dogukanburda/Multichannel_Analyzer/Design Project 1.pdf

# ISTANBUL TECHNICAL UNIVERSITY

## FACULTY OF SCIENCE AND LETTERS

## Physics Engeering Design I Report

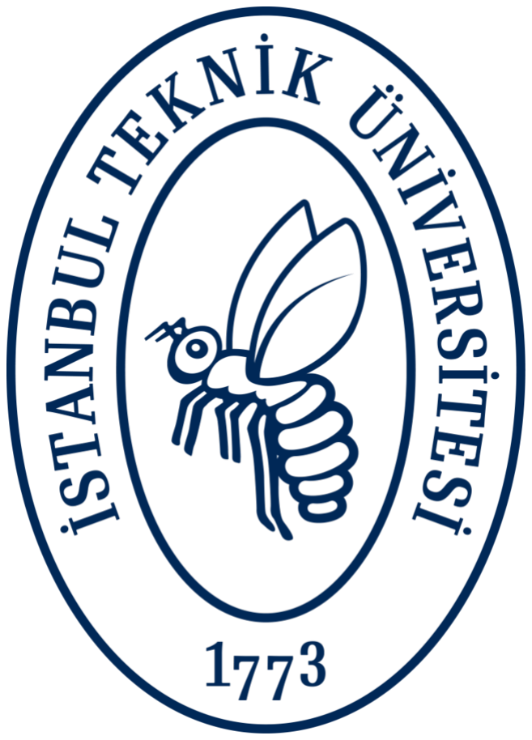
[picture p1: figure]

## Design of a microprocessor based multichannel analyzer for radon detection

### Osman Do˘gukan Kefeli

Department : Physics Engineering

ID | : 090170119
Advisor | : Prof. Dr. Cenap S¸. Ozben ¨
| Spring 2020/2021

## ABSTRACT

This report describes the design of a microprocessor based multichannel analyzer going to be used for radon detection. A silicon PIN photodiode was used for detecting alpha particles. The main advantages of this design are being low cost and low power consumption. Detector in question is planned to be used in the project related to the prediction of eqrtquakes by measuring radon levels in soil. Radon is a naturally occuring noble gas originated from radioactive decay series of 238U,²³⁵U. Since it lacks

any odor, taste it is impossible for humans to sense. However, it is possible to measure the activity of radon in desired location with modern nuclear instrumentation. Radon gas emissions must concern every household medically because respiration of high concentrations of radon poses great danger to lung health. In order to measure radon activity levels, designing and building a compact, self-sufficient device would be extremely beneficial. Therefore the aim of this study is to utilize modern equipments to detect radioactivity and gather relevant data. Data acquisiton from the silicon PIN photodiode is achieved with a pulse amplifying circuitry and a microcontroller unit. This data then displayed simultaneously for nuclear spectroscopy for radon gas.

i

## ACKNOWLEDGEMENTS

I would like to express my deepest appreciation to my advisor Prof. Dr. Cenap S¸. OZBEN for guiding me in the steps of this work. ¨

Osman Do˘gukan Kefeli

ii

### CONTENTS

ABSTRACT | i
ACKNOWLEDGEMENTS | ii
CONTENTS | iii
ABBREVIATION | iv
1 INTRODUCTION | 1
2 MICROPROCESSOR AND COMPONENTS | 7
3 Results and Discussion | 11
4 Conclusion | 13
5 Appendix | 14
REFERENCES | 20

iii

### ABBREVIATIONS

α | Greek letter minuscule alpha
β | Greek letter minuscule beta
γ | Greek letter minuscule gamma
µs | Micro Second
MCA | Multi Channel Analyzer
MeV | Mega Electron Volt
Ra | Radium
Rn | Radon
ROI | Region Of Interest
T h | Thorium
U | Uranium

iv

### INTRODUCTION

Radiation is the release of energy in the form of moving waves or streams of particles. In nuclear physics there are four main types of radiation and therefore different radiation detection methods. These four main radiation types are heavy charged particles, β (beta) particles, X and γ (gamma) rays and neutrons. Since

the radiation is a form of energy, in nuclear physics this energy is presented in MeV scale. An electron-volt eV is defined as the energy to accelerate one electron in 1V potential. Which the energy corresponds to a few picojoules.

## 1.1 Detection of Radiation

There are various methods for radiation detection. Each technique is used for analyzing different parameters. Detection of radiation can be seperated into four main subclasses with respect to their purposes. First, instinct is to directly detect the existence of radiation process in the environment. This method classifies the existence of the radiation by a threshold parameter and gives a definitive result. Another neccesity is to monitor the radiation with respect to time to get information about source strength. Third method is analyzing the radiation in order to determine the source’s type. This can be done by energy spectroscopy methods. Another commonly used procedure is dosimetry. Dosimetry is a technique of measuring and calculating how much radiation a material or living tissue is exposed to, directly or indirectly, to radioactive radiation. In the field of medicine, the amount of radiation given to patients for treatment is measured by dosimetry methods and kept under control.
Radiation characteristics consist of three main classifications. X and Gamma rays interact with the spins of electrons in the target material and cause ionization. On the other hand, heavy ions interact with both target electrons and nuclei and uncharged particles such as neutrons interact with the target nucleus. They are either absorbed or scattered from the target nucleus. Uncharged particles do not scatter from electrons.
The operation of any radiation detector is largely determined by how the radiation to be detected interacts with the detector’s material [1]. In order to construct a

radiation detection system first of all targeted radiation type must taken into account. Then operating range must be optimized to the target intensity for efficiency. Radon detection system can be constructed with instrumentation of solid-state silicon detectors. This electronic components are able to detect alpha particles emitted by radon.

## 1.2 Nuclear Spectroscopy

Nuclear spectroscopy used as a quick analytical method for applications like isotope identification [2], nuclear forensics [3], astrophysics [4], medical diagnosis [5]

etc. Nuclear spectroscopy includes measurements of gamma rays, charged particles and neutrons emitted from the nuclear reactions or decay of radioactive nuclei. It is mainly utilized with the properties of individual levels such as energy, angular momentum, spin, magnetic and electric moments and transition rates. In nuclear spectroscopy, energy is emitted as beta radiation, alpha radiation or in the form of photons in the gamma-ray range. With the help of mesasurement techniques radiation spectrum of the nucleus is detected in order to identify certain properties to discover the unknown. Instrumentation of electronics to detect the energies emitted by the nuclei have enabled advanced nuclear spectroscopy methods, resulting a more precise enviroment for nuclear data analysis. Further developments have made nuclear physics revolutionary for fields such as nuclear forensics, homeland security, imaging and diagnostics, radiation treatment, material science, art and archaeology. In digital nuclear spectroscopy, the digitizer plays the most important role in the performance of the spectrum analyzer system.

## 1.3 Single Channel Analyzer

Single channel analyzers have been used for measuring pulse amplitude. Single channel analyzer has two adjustable voltage tresholds and produces an output logic pulse depending on the conditions that its input signal falls within the two pre-set treshold levels [6].

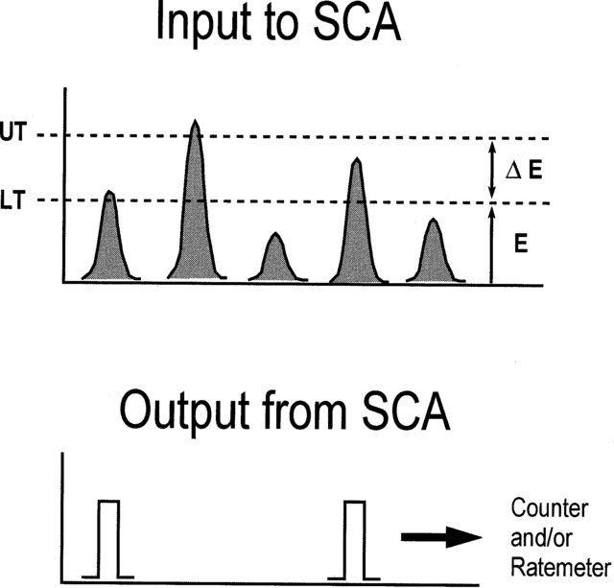
[picture p2: figure]

Figure 1.1: Pulse height analysis in a single-channel analyzer [7].

Figure above shows that pulses that yields between lower threshold (LT) and upper treshold (UT) digitized as a TTL pulse by the single channel analyzer. This is a good

practice for counting the rate of a certain radiation that has known characteristic energy.
However, when it is important to measure the corresponding energy of each pulse, this process must be done for every small ∆E energy range covering from the ground up. For this purpose multi channel analyzers evolved and utilized from the single channel analyzers. In principle a MCA, equivalent to many independent single channel analyzers consists of conitinous arranged windows [8]. Due to rapid

advancements in semiconductor and integrated circuit technology, today’s spectrometry system generally includes an analog-to-digital converter (ADC) for digitizing

the input pulse.

## 1.4 Multi Channel Analyzer

The multi channel analyzer (MCA) system consists of several key principle com-

ponents. These are simply data acquisition module, processing and storage unit, an analog-to-digital converter and a visual display module. MCA scans each energy channel that the system is capable of measuring. Records the number of pulse counts for each energy and logs the data in attainable format for determining the nuclide in nuclear spectroscopy system.
The ADC conversion unit utilizes the electrical analog signals to equivalent bytes to make sense in digital interface for further computational analysis.
Multi channel analyzer operates in two different modes. First one is pulse height analyzer mode, input pulses are mapped to bins by their amplitudes. Each bin represents an energy range and this its precision depends on the analyzer’s resolution. Second mode is the multi channel scaler mode, where pulses are sorted according to the time of arrival. MCA in design provides a visual display for realtime monitoring of the pulse height spectrum. Graph displayed on the screen provides the number of counts vs. channel number, basically a histogram of the number of counts vs pulse height. Number of pulse heights are analyzed with upper and lower level discriminators that can be adjusted manually.

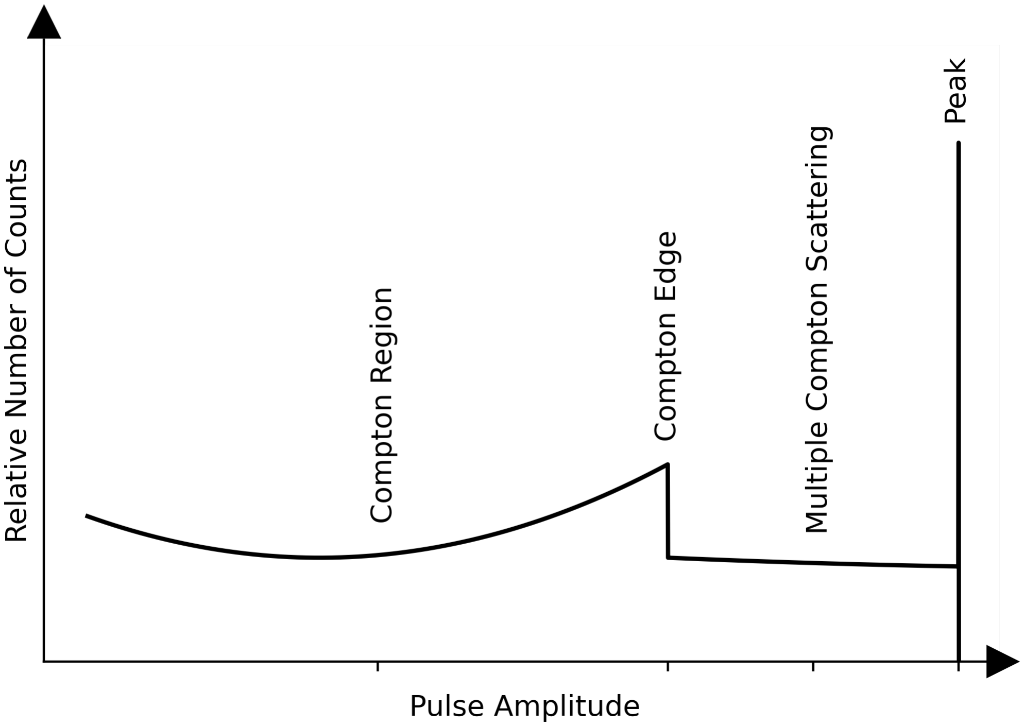
[picture p3: figure]

Figure 1.2: Ideal spectrum of a multi-channel analyzer.

Pulse height spectrometry examines the amplitudes of signals being received from the detector. This spectrometry describes how energy is transferred in a crystal. Pulse heights are generated from photoelectric interaction within the crystal that creates a charge proportional to incident particles energies that are deposited in the crystal structure. Ideally its expected to see energies piled up at a certain energy. When compton scattering occurs inside the detector only a part of the energy is deposited in the crystal. The energy deposition from Compton scattering events depends on the defection of the scattering.

### 1.4.1 Analog to Digital Converter

Since measuring radiation is done by converting deposited energies into voltages and radiation energies are proportional with the induced voltages in the detector, one must precisely measure analog signals. Data acquisition systems are used to detect these analog signals and convert them to digital form [9]. An ADC converts

continuous analog signal to discrete digital signal.

Resolution

The ADC resolution referred as the lowest incremental voltage that creates a change in the digital output. The resolution of the converter is also defined as the number of different values that converter is able to output. Number of discrete values usually power of two. For example an ADC with 8-bit resolution can encode an analog signal to 256 levels
(2⁸ = 256)

. Therefore digital output signal must be in range of 0-255, an unsigned 8-bit integer. The smallest incremental voltage can be expressed with respect to reference voltage. For example with a 3.3 V reference voltage, the resolution of an 8-bit ADC is

3.3V
2

8

= 12.890625mV

With this property the ADC has a quantization error. This error is determined by the least significant bit (LSB) of the ADC, and in the example, ADC has a quantization error of 1/256 of the total signal range which means that original analog input value

can be 12.890625 mV lower.

Sampling Rate

Analog signals are continuous and it is required to digitize to a discrete value at a certain time. Sampling rate is defined as the how fast a new digital value is sampled from the continuous analog signal. The Nyquist-Shannon sampling theorem
[10] tells that sampling rate should be higher than twice of the frequency of the signal to trust the generated signal. The ADC clock of Atmega328P is 16 MHz divided by a ‘prescale factor’. The prescale is set by default to 128 which leads to 16MHz/128 = 125 KHz ADC clock. Since a single conversion takes 13 ADC clocks, the default sampling rate is around 9600 Hz [11].

Conversion Time

Practical ADC cannot make an instantaneus conversion. Input value must be held constant for a interval of time. This time is specified as the conversion time. Integrated ADC modules contains an embedded sample and hold circuitry inside to provide the conversion time. How fast can an ADC measure is determined by this quantity.

## 1.5 Silicon PIN photodiodes

A photodiode is similar to a PN junction diode in that it generates electric current using voltage as the energy source, but PIN (P-Intrinsic-N) photodiodes generate

electrical signal using both voltage and light.

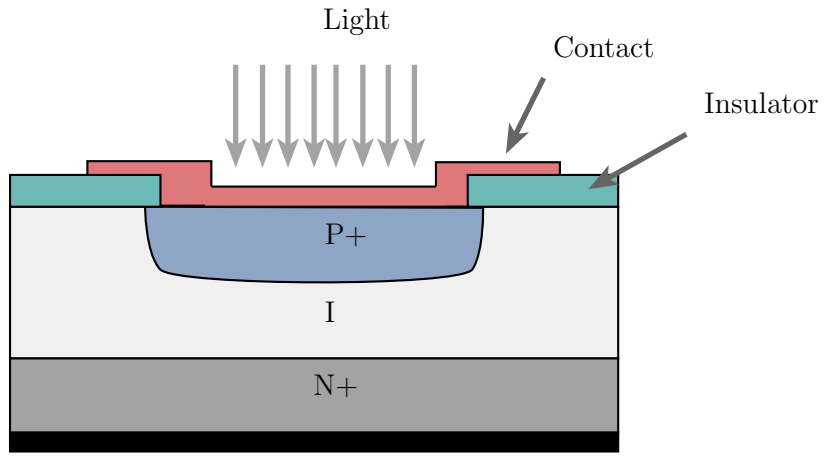
[picture p4: figure]
Light; Contact; Insulator

Figure 1.3: PIN photodiode structure [12].

A moderate reverse bias is used to operate the photodiode. This prohibits any carriers from entering depletion layer, therefore no current will flow. When a photon hits the intrinsic region, it can interact with an atom in the crystal lattice, dislodging one electron. A hole-electron pair is created in this method. Under the influence of the electric field, the hole and electron will travel in opposite directions across the intrinsic region, causing a tiny current to flow. The size of the current is found to be related to the amount of light that enters the intrinsic region. The more light, the greater the numbers of hole electron pairs that are generated and the greater the current flowing.

### MICROPROCESSOR AND COMPONENTS

## 2.1 Microcontroller Unit

To analyze the full spectrum, values received from ADC component must be stored in some sort of device. A simple ATmega based microcontroller device have been used. For convenience sake a simple Arduino that is available and also relatively cheap can be used.

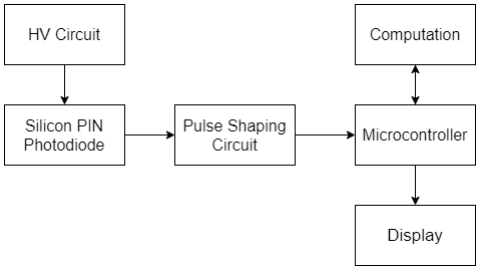
[picture p5: figure]

Figure 2.1: Block diagram.

Values obtained from the ADC can easily be stored, operated according to the needs and also spectrum histogram can be displayed for real-time analysis.

## 2.2 Pulse Amplifier Circuit

To read the incoming signal generated from silicon PIN photodiode, it must first be amplified. The amplified signal passes through a comparator and gives the read signal to the microcontroller when input pulse is above the pre-determined noise level. Microcontroller is able to read the analog signal that is outputted from the peak-holder circuit.
Pulse acquisiton system operates as follows, firstly the storage capacitor of the peak-detector is discharged. Then continously reading and waiting for a high signal from the LM311 comparator. When high signal is acquired from comparator, output signal is immediatly read and capacitor is discharged by a reset pulse applied to IRF840 MOSFET’s gate, therefore a consecutive pulse can be read. Reading in the voltage of the capacitor is equal to the maximum voltage of the incoming pulse.

## 2.3 Peak Holder Circuit

To retrieve the low and narrow pulse, a peak sample holder circuit must be utilized. With the peak-holder part of the circuit it is possible to hold and extend the short-width pulse’s height and read the analog voltage with the microcontroller. Since the capacitor voltage can be discharged with the reset pulse generated from the microcontroller that delivered to the MOSFET’s gate, microcontroller can read consecutive pulses.

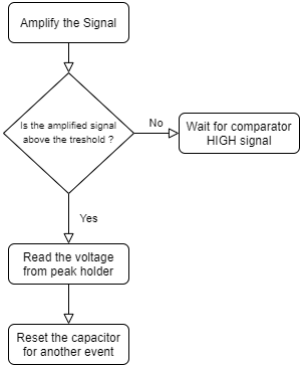
[picture p6: figure]

Figure 2.2: Flowchart diagram.

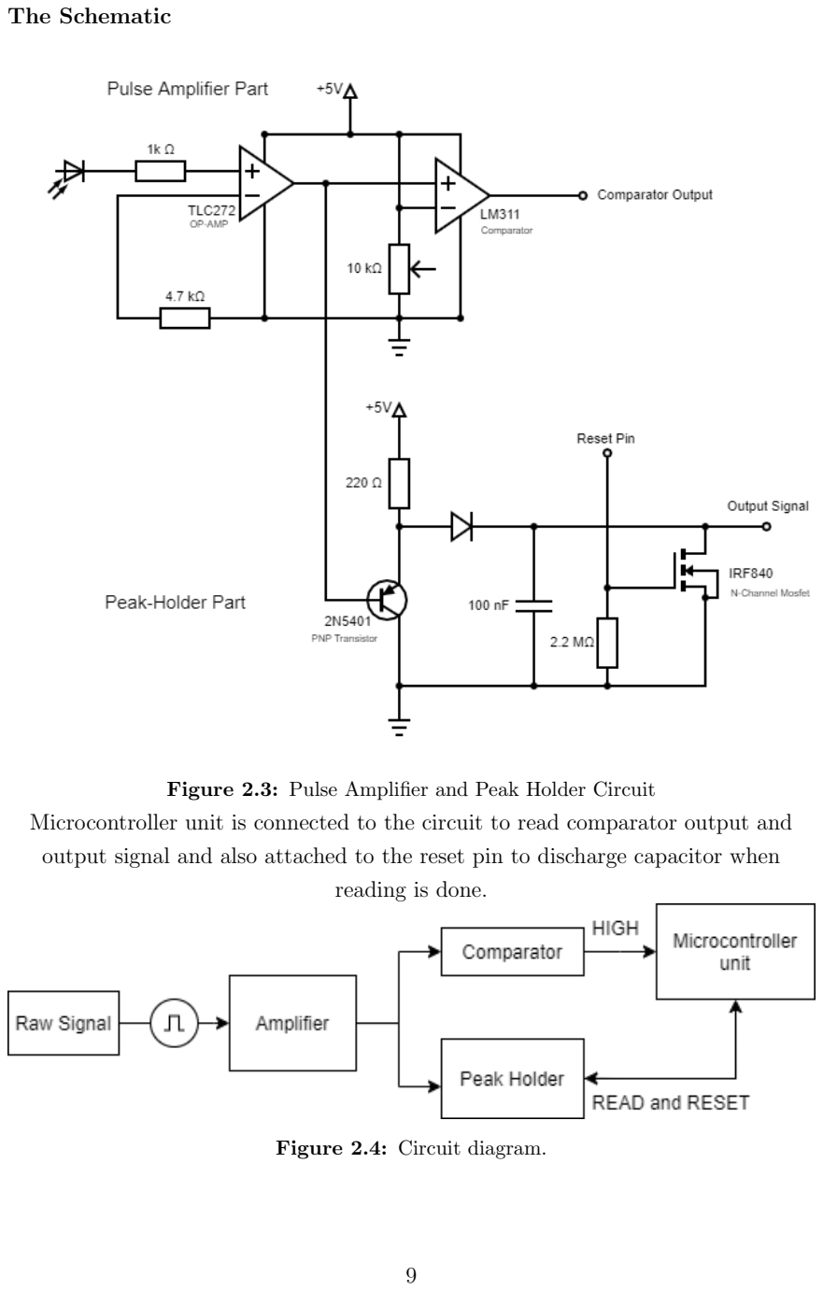
[picture p7: page 14]

The Schematic

Figure 2.3: Pulse Amplifier and Peak Holder Circuit Microcontroller unit is connected to the circuit to read comparator output and output signal and also attached to the reset pin to discharge capacitor when reading is done.

Figure 2.4: Circuit diagram.

## 2.4 Data Visualisation

The data were then displayed as histograms which then could be subjected to the traditional analysis to obtain peak parameters and the associated quantities. Visualisation of spectroscopy is an important part in order to get information at first look. In this study an ST7735 TFT LCD panel with SPI communication protocol is used to monitor the histogram of the signals in real-time.
Radiation spectrum does not only contains the source’s radiation but also affected by the background radiation of lower energies that are generated from 40K present

in the sand that are used on the walls. So, in order to analyze a certain region two dividers have been set and can be configured by two rotating handles. This allows the specification of the region of interest (ROI). With the help of the microprocessor,

divider’s corresponding channel numbers and number of pulses that are between the two dividers are displayed at the lower region of the display. In order to use microcontroller computations efficiently, it is important to refresh the spectrum only when a new pulse is acquired.

### Results and Discussion

Resulting pulses coming from the detector is amplified to be in between 0-5 volts which is which is ADC’s reference voltages. Comparator threshold can be set to around 200 mV to eliminate some of the noise. On the peak holder circuit With the right selection of capacitor and a load resistor, it is possible to manipulate a 35 microsecond pulse to decay in 25 miliseconds, that is around 700 times larger. Arduino Mega’s microprocessor with the 16 MHz ADC clock of Atmega328P a reading can be executed every 104 µs.

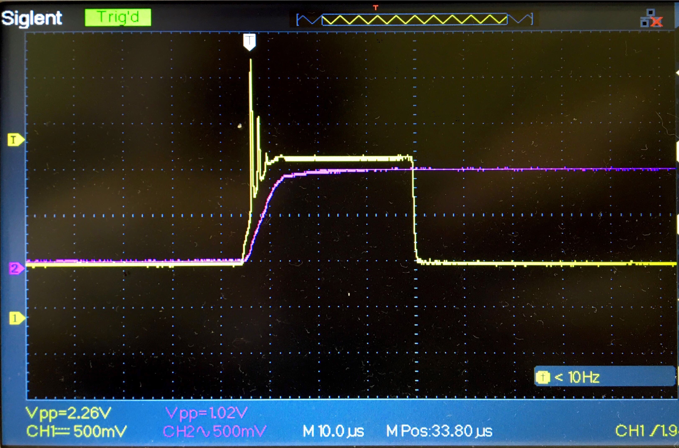
[picture p8: figure]

Figure 3.1: Incoming pulse (Yellow) and peak-holder output (Purple). Each division is 10 µs.

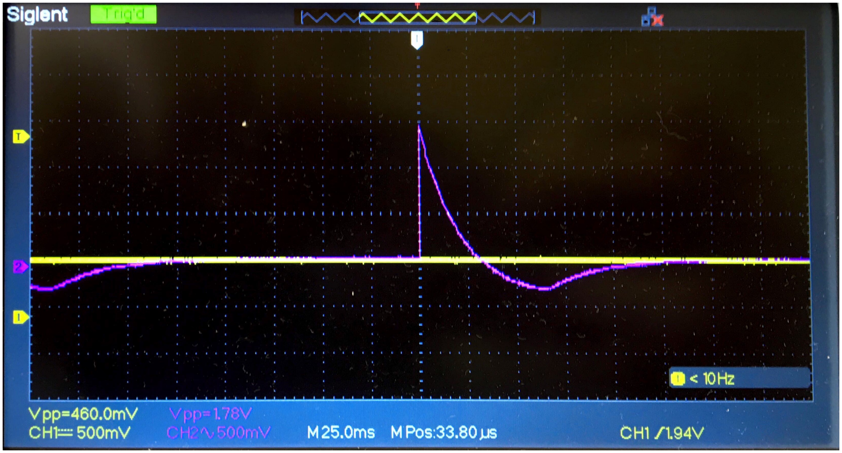
[picture p9: figure]

Figure 3.2: Incoming pulse (Yellow) and peak-holder output (Purple). Each division is 25 ms.

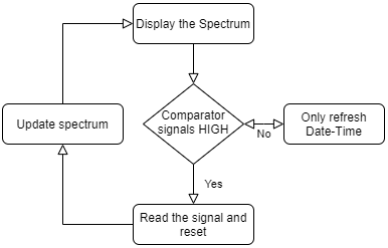
[picture p10: figure]

Figure 3.3: Flowchart of data acquisiton and displaying block.

It is crucial to refresh the spectrum only when a new pulse is acquired in order to make the most of microcontroller computations.

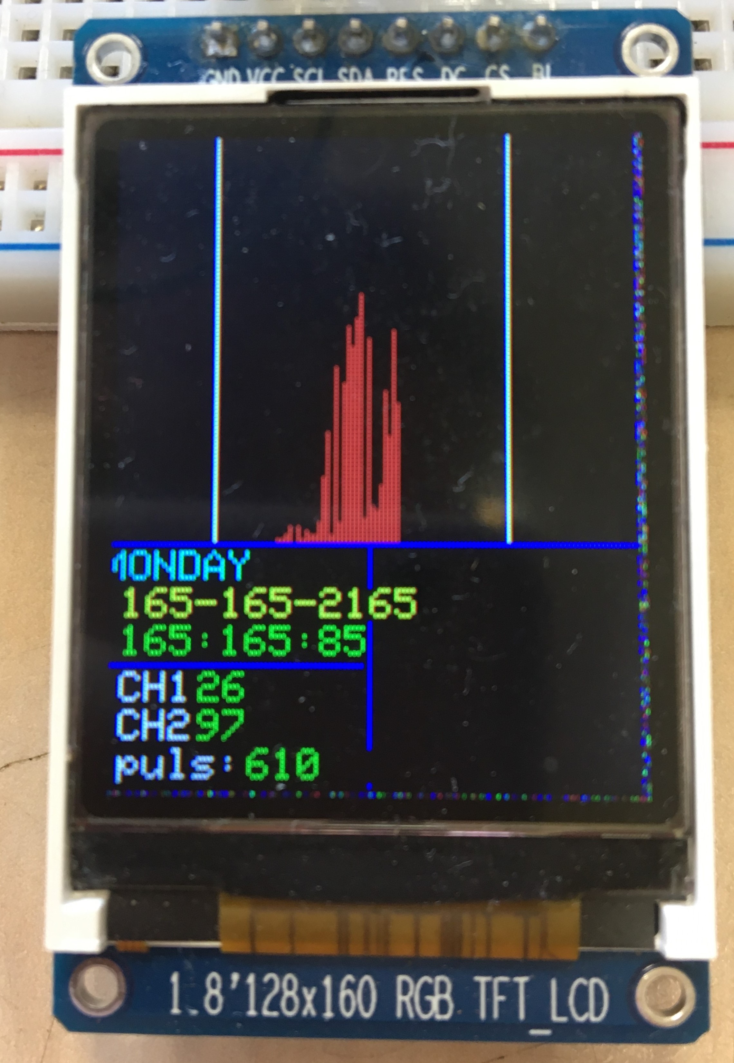
[picture p11: figure]

Figure 3.4: Layout of LCD display.

Histogram and the adjustable region of interest is seen on the display,

### Conclusion

A multichannel analyzer which utilises a microcontroller as the digitiser, to adequately digitise the amplified pulses from a silicon PIN photodiode based radiation detector has been developed. This work showed that the detector and the instrumentation presented in this study can be used for measuring the alpha radiation of 226Ra decay. Thus measurements clearly be monitored by a single display. With this

design that has minimal and easy to find components, it is possible to produce large amounts of detectors. Which leads to more control over the knowledge of radiation throughout geographic area of interest such as Anatolia’s fault lines and possible geodemographic analysis’.

### Appendix

Working example code:

1 | #include <Adafruit_GFX.h> | // Core graphics library
2 | #include <Adafruit_ST7735.h> // Hardware-specific library for ST7735
3 | #include <SPI.h>
4 | #include <RTClib.h> | // include Adafruit RTC library

5
6 | // Defining SPI Pins for TFT LCD
7 | #define TFT_CS | 53
8 | #define TFT_RST | 9
9 | #define TFT_DC | 8

10

11
12 | Adafruit_ST7735 tft = Adafruit_ST7735(TFT_CS, TFT_DC, TFT_RST);
13 | // Initialize RTC module and configure the days
14 | RTC_DS3231 rtc;
15 | DateTime | now;
16 | char daysOfTheWeek[7][12] = {"Sunday", "Monday", "Tuesday", "Wednesday",
,→ | "Thursday", "Friday", "Saturday"};
17 | char dow_matrix[7][10] = {"SUNDAY", "MONDAY", "TUESDAY", "WEDNESDAY",
,→ | "THURSDAY", "FRIDAY", "SATURDAY"};

18

19
20 | char _buffer[11];
21 | float p = 3.1415926;
22 | int pulslar[128]; // For drawing on LCD
23 | int original_log[128]; | // For keeping the original logs of pulses
24 | int toplam_puls; | // To display the number of pulses occurred in
,→ | the region of interest (ROI)
25 | float faktor=1; | // Multiplying factor for the histogram to not
,→ | exceed the screen

26
27 unsigned long oncekizaman = 0;

28
29 | byte x_pos[7] = {8, 8, 6, 4, 4, 8, 4}; // 29,29,23,11,17,29,17
30 | static byte previous_dow = 8;

31
32 | void setup(void) {
33 | Serial.begin(9600);
34 | tft.initR(INITR_BLACKTAB);
35 | rtc.begin();
36 | rtc.adjust(DateTime(F(__DATE__), F(__TIME__)));
37 | //pinMode(2, INPUT);
38 | pinMode(2, INPUT); // comparator ¸cıkı¸sı pin 2
39 | pinMode(3, OUTPUT); | //reset pulse'ı pin 3

40
41 | int tolam_puls = 0;
42 | for (int i = 0; i < 128; i++)
43 | {
44 | pulslar[i] = 0;
45 | }
46 | for (int i = 0; i < 128; i++)
47 | {
48 | original_log[i] = 0;
49 | }
50 | // Use this initializer if using a 1.8" TFT screen:
51 | tft.initR(INITR_BLACKTAB); | // Init ST7735S chip, black tab
52 | tft.fillScreen(ST77XX_BLACK);
53 | tft.fillScreen(ST77XX_BLACK);
54 | // Drawing the outline of sections for the display
55 | tft.drawFastHLine(0, 130, 63, ST7735_BLUE);
56 | tft.drawFastHLine(0, 101, tft.width(), ST7735_BLUE);
57 | tft.drawFastVLine(64, 100, 59, ST7735_BLUE);
58 | tft.drawFastHLine(0, 100, | tft.width(), ST7735_BLUE);
59 | tft.setTextColor(ST7735_WHITE, ST7735_BLACK); | // set text color to
,→ | white and black background
60 | tft.setTextSize(1); | // text size = 1
61 | //Outline for dividers' value and toplam puls
62 | tft.setTextSize(1);
63 | tft.setTextColor(ST7735_WHITE, ST7735_BLACK);
64 | tft.setCursor(4,132); | // For the first Divider
65 | tft.print("CH1:" );
66 | tft.setCursor(4,141); | // For the second Divider
67 | tft.print("CH2:" );
68 | tft.setCursor(4,150); | // For the Total pulses between dividers
69 | tft.print("puls:");

70

71 }

72
73 | void loop() {
74 | unsigned long ilkzaman = millis();
75 | int val = digitalRead(2);
76 | if (val == 1) {
77 | int deger = analogRead(A5); | // genli˘gi okudu˘gum pin A5
78 | digitalWrite(3,HIGH);
79 | delayMicroseconds(1);
80 | digitalWrite(3,LOW);

81
82 | Serial.println(deger);
83 | int toplam_puls = 0;
84 | now = rtc.now(); | // read current time and date from the RTC chip
85 | tft.setCursor(x_pos[previous_dow], 103);
86 | tft.setTextColor(ST7735_CYAN, ST7735_BLACK); | // set text color to
,→ | cyan and black background
87 | tft.print( dow_matrix[now.dayOfTheWeek()] );

88

89
90 | // print date
91 | sprintf( _buffer, "%02u-%02u-%04u", now.day(), now.month(), now.year()
,→ | );
92 | tft.setCursor(4, 112);
93 | tft.setTextColor(ST7735_YELLOW, ST7735_BLACK); | // set text color to
,→ | yellow and black background
94 | tft.print(_buffer);

95
96 | // print time
97 | sprintf( _buffer, "%02u:%02u:%02u", now.hour(), now.minute(),
,→ | now.second() );
98 | tft.setCursor(4, 121);
99 | tft.setTextColor(ST7735_GREEN, ST7735_BLACK); | // set text color to
,→ | green and black background
100 | tft.print(_buffer);

101
102 | int Index = map(deger,0,1023,0,127);
103 | original_log[Index] = original_log[Index] + 1; | // Reads from analog
,→ | pin and appends to the right channel accordingly

104
105 | bool flag=1;
106 | pulslar[Index] = pulslar[Index] + 1;

107
108 | for(int t=0;t<127&&flag==1;t++){ | // This code is for
,→ | checking if the pulses exceeded display screen
109 | if(pulslar[t]>100/faktor){ | // Needs to be
,→ | optimized.
110 | faktor=faktor/2;
111 | flag=0;
112 | }
113 | }

114
115 | unsigned char div0 = map(analogRead(A3),0,1023,0,127); //first divider
,→ | index between 0-127
116 | unsigned char div1 = map(analogRead(A1),0,1023,0,127); //second divider
,→ | index between 0-127

117
118 | for (int i = 0; i < 128; i++){
119 | tft.drawLine(i,100,i,100-pulslar[i],ST7735_RED);
120 | tft.drawLine(i,100-int(faktor*pulslar[i]),i,0,ST7735_BLACK);
121 | //tft.drawLine(div0,100,div0,0,ST7735_WHITE);
122 | //tft.drawLine(div1,100,div1,0,ST7735_WHITE);
123 | }

124

125
126 | tft.drawLine(div0,100,div0,0,ST7735_WHITE);
127 | tft.drawLine(div1,100,div1,0,ST7735_WHITE);
128 | if( div0 < div1){
129 | for (int i = div0; i < div1; i++){
130 | toplam_puls = toplam_puls + original_log[i];
131 | }
132 | }
133 | else {
134 | for (int i = div1; i < div0; i++){
135 | toplam_puls = toplam_puls + original_log[i];
136 | }
137 | }

138
139 for (int i = div0+1; i < div1; i++)

140 | {
141 | tft.drawLine(i,100,i,100-pulslar[i],ST7735_RED);
142 | tft.drawLine(i,100-int(faktor*pulslar[i]),i,0,ST7735_BLACK);
143 | }
144 | tft.drawLine(div0,100,div0,0,ST7735_WHITE);

145

146
147 | tft.setCursor(23,132);
148 | tft.print(div0);
149 | tft.print(" | ");
150 | tft.setCursor(23,141);
151 | tft.print(div1);
152 | tft.print(" | ");

153
154 | tft.setCursor(35,150);
155 | tft.print(toplam_puls);
156 | tft.print(" | ");
157 | unsigned long ikincizaman = millis();
158 | unsigned long timer=ikincizaman-ilkzaman;
159 | Serial.println(timer);
160 | }
161 | }

162

163
164 | void RTC_display()
165 | {
166 | char _buffer[11];
167 | char dow_matrix[7][10] = {"SUNDAY", "MONDAY", "TUESDAY", "WEDNESDAY",
,→ | "THURSDAY", "FRIDAY", "SATURDAY"};
168 | byte x_pos[7] = {8, 8, 6, 4, 4, 8, 4}; // 29,29,23,11,17,29,17
169 | static byte previous_dow = 8;

170
171 | // print day of the week
172 | if( previous_dow != now.dayOfTheWeek() )
173 | {
174 | | previous_dow = now.dayOfTheWeek();
175 | // | tft.fillRect(11, 55, 108, 14, ST7735_BLACK); | // draw rectangle
| ,→ | (erase day from the display)
176 | | tft.setCursor(x_pos[previous_dow], 103);

177 | tft.setTextColor(ST7735_CYAN, ST7735_BLACK); | // set text color to
,→ | cyan and black background
178 | tft.print( dow_matrix[now.dayOfTheWeek()] );
179 | }

180
181 | // print date
182 | sprintf( _buffer, "%02u-%02u-%04u", now.day(), now.month(), now.year()
,→ | );
183 | tft.setCursor(4, 112);
184 | tft.setTextColor(ST7735_YELLOW, ST7735_BLACK); | // set text color to
,→ | yellow and black background
185 | tft.print(_buffer);

186
187 | // print time
188 | sprintf( _buffer, "%02u:%02u:%02u", now.hour(), now.minute(),
,→ | now.second() );
189 | tft.setCursor(4, 121);
190 | tft.setTextColor(ST7735_GREEN, ST7735_BLACK); | // set text color to
,→ | green and black background
191 | tft.print(_buffer);
192 | }

### REFERENCES

[1] Glenn F. Knoll. Radiation Detection and Measurement. John Wiley Sons, Inc,

3rd edition, 2000. ISBN 0-471-07338-5.

[2] Kenneth D. Jarman, Robert C. Runkle, Kevin K. Anderson, and David M. Pfund. A comparison of simple algorithms for gamma-ray spectrometers in radioactive source search applications. Applied Radiation and Isotopes, 66 (3):362–371, 2008. ISSN 0969-8043. doi: https://doi.org/10.1016/j.apradiso.

2007.09.010. URL https://www.sciencedirect.com/science/article/pii/

S0969804307002886. (https://www.sciencedirect.com/science/article/pii/S0969804307002886)

[3] Erik B. Johnson, Chad Whitney, Keith E. Holbert, Taipeng Zhang, Tyler Stannard, Anthony Christie, Peter Harper, Blake Anderson, and James F. Christian. Activation analysis study on li-ion batteries for nuclear forensic applications. Nuclear Instruments and Methods in Physics Research Section A: Accelerators, Spectrometers, Detectors and Associated Equipment, 784:430–437, 2015. ISSN 0168-9002. doi: https://doi.org/10.1016/j.nima.2015.01.046. URL https://

www.sciencedirect.com/science/article/pii/S0168900215000777. Symposium on Radiation Measurements and Applications 2014 (SORMA XV).

[4] R. Longland, C. Iliadis, A.E. Champagne, C. Fox, and J.R. Newton. Nuclear

astrophysics studies at the lena facility: The -ray detection system. Nuclear Instruments and Methods in Physics Research Section A: Accelerators, Spectrometers, Detectors and Associated Equipment, 566(2):452–464, 2006. ISSN
0168-9002. | doi: https://doi.org/10.1016/j.nima.2006.07.006. | URL https:

//www.sciencedirect.com/science/article/pii/S0168900206012599.

[5] Paul E. Kinahan and Joel S. Karp. Position estimation and error correction in a 2d position-sensitive nai(tl) detector. Nuclear Instruments and Methods in Physics Research Section A: Accelerators, Spectrometers, Detectors and Associated Equipment, 299(1):484–489, 1990. ISSN 0168-9002. doi: https://doi.org/10.1016/0168-9002(90)90829-U. URL https://www.sciencedirect.com/

science/article/pii/016890029090829U. (https://www.sciencedirect.com/science/article/pii/016890029090829U)

[6] James Kelly Milam. Single-Channel Analyzers, pages 245–261. Springer US, Boston, MA, 1973. ISBN 978-1-4684-1953-5. doi: 10.1007/978-1-4684-1953-5 8.

URL https://doi.org/10.1007/978-1-4684-1953-5_8.

[7] Nicole Ranger. The aapm/rsna physics tutorial for residents. RadioGraphics, 19:481–502, 03 1999. doi: 10.1148/radiographics.19.2.g99mr30481.
[8] P.W. Nicholson. Nuclear electronics. Wiley, illustrated edition, 1974. ISBN

0471636975, 9780471636977.

[9] Texas Instruments. Principles of data acquisition and conversion, 04-2015. [On-

line]. URL https://www.ti.com/lit/an/sbaa051a/sbaa051a.pdf.

[10] C.E. Shannon. Communication in the presence of noise. Proceedings of the IRE, 37(1):10–21, 1949. doi: 10.1109/JRPROC.1949.232969.
[11] 8-bit AVR Microcontroller with 32K Bytes In-System Programmable Flash.

Atmel Corporation, 2015. URL https://ww1.microchip.com/downloads/

en/DeviceDoc/Atmel-7810-Automotive-Microcontrollers-ATmega328P_ Datasheet.pdf. (https://ww1.microchip.com/downloads/en/DeviceDoc/Atmel-7810-Automotive-Microcontrollers-ATmega328P_Datasheet.pdf) Rev.: 7810D–AVR–01/15.

[12] Electronics | Notes. | Photodiode | structures. | URL | https://www.

electronics-notes.com/articles/electronic_components/diode/

photodiode-detector-structures-fabrication-materials.php. (https://www.electronics-notes.com/articles/electronic_components/diode/photodiode-detector-structures-fabrication-materials.php)
