dogukanburda/Multichannel_Analyzer/images/schematic.png

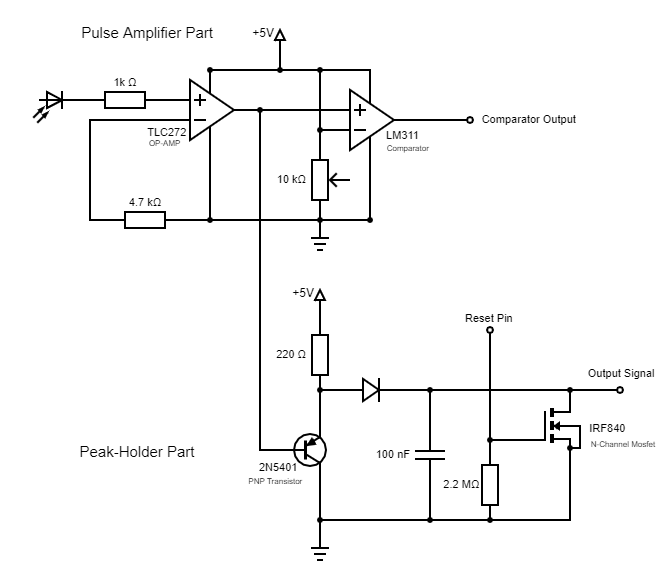
images/schematic.png
